Jianan-Li/Tiny-Tetris/Electrical Design/Tiny Tetris v1.3.brd

## EAGLE design Electrical Design/Tiny Tetris v1.3.brd (2014-08-16)

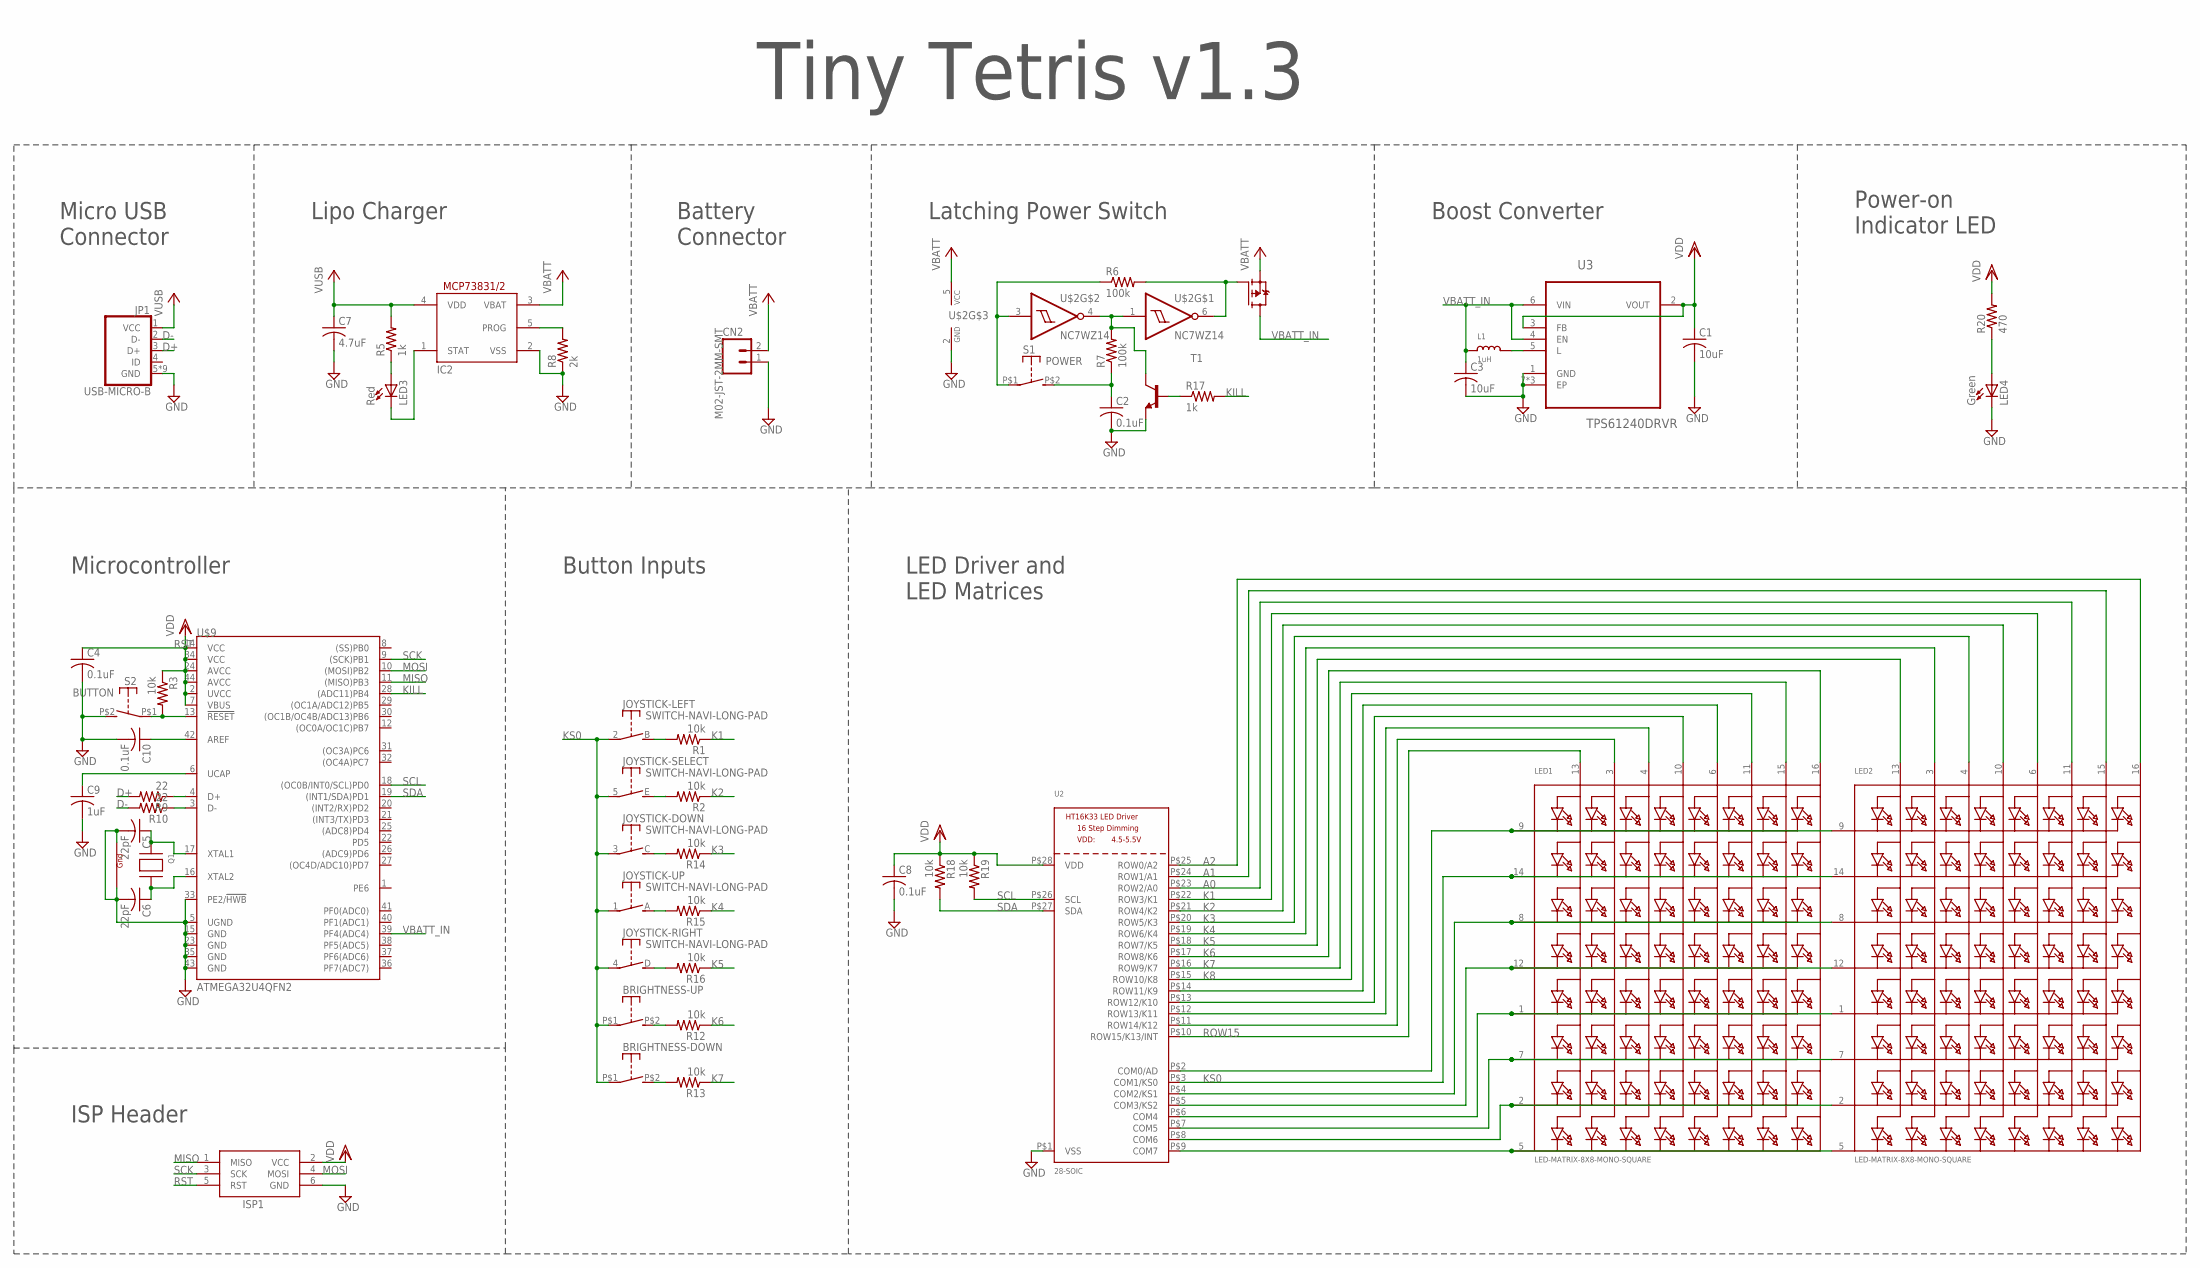
[picture p1: schematic Tiny Tetris v1.3.sch]

Parts:
BRIGHTNESS-DOWN: SWITCH-TACTSKRELGE010; TACT-ALPS-SKRELGE010
BRIGHTNESS-UP: SWITCH-TACTSKRELGE010; TACT-ALPS-SKRELGE010
C1, C3: 10uF; C0603K
C2, C4, C8, C10: 0.1uF; C0603K
C5, C6: 22pF; C0603K
C7: 4.7uF; C0603K
C9: 1uF; C0603K
CN2: M02-JST-2MM-SMT; 1X02_NO_SILK
IC2: MCP73831/OT; SOT23-5L
ISP1: AVRISP-6; AVRISP
JOYSTICK-: SWITCH-NAVI-LONG-PAD; JOYSTICK-NOKIA-3230-LONG-PAD
JP1: USB-MICRO-B; MICRO-USB-FCI-10103594
L1: 1uH; 0805
LED1, LED2: LED-MATRIX-8X8-MONO-SQUARE
LED3: Red; LED-0603-SIDEVIEW
LED4: Green; LED-0603-SIDEVIEW
Q1: XTAL-4-3225; NX3225
R1, R2, R3, R12, R13, R14, R15, R16, R18, R19: 10k; R0603
R5, R17: 1k; R0603
R6, R7: 100k; R0603
R8: 2k; R0603
R9, R10: 22; R0603
R20: 470; R0603
S1: POWER; TACT-ALPS-SKRELGE010
S2: BUTTON; TACT-ALPS-SKRELGE010
T1: MMBT2222ALT1-NPN-SOT23-BEC; SOT23-BEC
U2: 28-SOIC; SOP28_300MIL
U3: TPS61240DRVR; SON65P200X200X80-7N
U$1: IRLML6402; SOT23
U$2: NC7WZ14; SC-70-6
U$9: ATMEGA32U4QFN2; SPARKFUN-DIGITALIC_QFN-44-NOPAD

Connections:
A0: LED2.11 (A6), U2.P$23 (ROW2/A0)
A1: LED2.15 (A7), U2.P$24 (ROW1/A1)
A2: LED2.16 (A8), U2.P$25 (ROW0/A2)
D+: JP1.3 (D+), R9.2
D-: JP1.2 (D-), R10.2
GND: C1.2, C2.2, C3.2, C4.2, C5.2, C6.2, C7.2, C8.2, C9.2, C10.2, CN2.1, IC2.2 (VSS), ISP1.6 (GND), JP1.5 (GND), JP1.P$1 (GND), JP1.P$2 (GND), JP1.P$3 (GND), JP1.P$4 (GND), JP1.P$5 (GND), JP1.P$6 (GND), JP1.P$7 (GND), JP1.P$8 (GND), LED4.P$2 (C), Q1.2 (G2), Q1.4 (G1), R8.1, S2.P$2 (S), T1.E, U2.P$1 (VSS), U3.1 (GND), U3.7 (EP), U3.8 (EP), U3.9 (EP), U$2.2 (GND), U$9.5 (UGND), U$9.15 (GND), U$9.23 (GND), U$9.33 (PE2/!HWB), U$9.35 (GND), U$9.43 (GND)
K1: LED2.6 (A5), R1.1, U2.P$22 (ROW3/K1)
K2: LED2.10 (A4), R2.1, U2.P$21 (ROW4/K2)
K3: LED2.4 (A3), R14.1, U2.P$20 (ROW5/K3)
K4: LED2.3 (A2), R15.1, U2.P$19 (ROW6/K4)
K5: LED2.13 (A1), R16.1, U2.P$18 (ROW7/K5)
K6: LED1.16 (A8), R12.1, U2.P$17 (ROW8/K6)
K7: LED1.15 (A7), R13.1, U2.P$16 (ROW9/K7)
K8: LED1.11 (A6), U2.P$15 (ROW10/K8)
KILL: R17.2, U$9.28 ((ADC11)PB4)
KS0: BRIGHTNESS-DOWN.P$1, BRIGHTNESS-UP.P$1, JOYSTICK-.1, JOYSTICK-.2, JOYSTICK-.3, JOYSTICK-.4, JOYSTICK-.5, LED1.14 (K2), LED2.14 (K2), U2.P$3 (COM1/KS0)
MISO: ISP1.1 (MISO), U$9.11 ((MISO)PB3)
MOSI: ISP1.4 (MOSI), U$9.10 ((MOSI)PB2)
unnamed: LED1.5 (K8), LED2.5 (K8), U2.P$9 (COM7)
unnamed: LED3.P$1 (A), R5.1
unnamed: JOYSTICK-.C (S), R14.2
unnamed: R6.2, U$1.1 (G), U$2.6 (O)
unnamed: R17.1, T1.B
unnamed: R6.1, S1.P$1, U$2.3 (I)
unnamed: JOYSTICK-.E (S), R2.2
unnamed: LED1.9 (K1), LED2.9 (K1), U2.P$2 (COM0/AD)
unnamed: JOYSTICK-.D (S), R16.2
unnamed: C2.1, R7.1, S1.P$2 (S)
unnamed: JOYSTICK-.B (S), R1.2
unnamed: R7.2, T1.C, U$2.1 (I), U$2.4 (O)
unnamed: JOYSTICK-.A (S), R15.2
unnamed: C10.1, U$9.42 (AREF)
unnamed: R9.1, U$9.4 (D+)
unnamed: IC2.1 (STAT), LED3.P$2 (C)
unnamed: IC2.5 (PROG), R8.2
unnamed: R10.1, U$9.3 (D-)
unnamed: C9.1, U$9.6 (UCAP)
unnamed: BRIGHTNESS-UP.P$2 (S), R12.2
unnamed: LED1.3 (A2), U2.P$11 (ROW14/K12)
unnamed: LED1.4 (A3), U2.P$12 (ROW13/K11)
unnamed: LED1.10 (A4), U2.P$13 (ROW12/K10)
unnamed: LED1.6 (A5), U2.P$14 (ROW11/K9)
unnamed: BRIGHTNESS-DOWN.P$2 (S), R13.2
unnamed: LED4.P$1 (A), R20.1
unnamed: L1.2, U3.5 (L)
unnamed: LED1.8 (K3), LED2.8 (K3), U2.P$4 (COM2/KS1)
unnamed: C5.1, Q1.1 (X1), U$9.17 (XTAL1)
unnamed: LED1.12 (K4), LED2.12 (K4), U2.P$5 (COM3/KS2)
unnamed: LED1.1 (K5), LED2.1 (K5), U2.P$6 (COM4)
unnamed: LED1.7 (K6), LED2.7 (K6), U2.P$7 (COM5)
unnamed: LED1.2 (K7), LED2.2 (K7), U2.P$8 (COM6)
unnamed: C6.1, Q1.3 (X2), U$9.16 (XTAL2)
ROW15: LED1.13 (A1), U2.P$10 (ROW15/K13/INT)
RST: ISP1.5 (RST), R3.2, S2.P$1, U$9.13 (!RESET)
SCK: ISP1.3 (SCK), U$9.9 ((SCK)PB1)
SCL: R19.2, U2.P$26 (SCL), U$9.18 ((OC0B/INT0/SCL)PD0)
SDA: R18.2, U2.P$27 (SDA), U$9.19 ((INT1/SDA)PD1)
VBATT: CN2.2, IC2.3 (VBAT), U$1.2 (S), U$2.5 (VCC)
VBATT_IN: C3.1, L1.1, U3.4 (EN), U3.6 (VIN), U$1.3 (D), U$9.39 (PF4(ADC4))
VDD: C1.1, C4.1, C8.1, ISP1.2 (VCC), R3.1, R18.1, R19.1, R20.2, U2.P$28 (VDD), U3.2 (VOUT), U3.3 (FB), U$9.2 (UVCC), U$9.7 (VBUS), U$9.14 (VCC), U$9.24 (AVCC), U$9.34 (VCC), U$9.44 (AVCC)
VUSB: C7.1, IC2.4 (VDD), JP1.1 (VCC), R5.2

Notes on the sheet:
Tiny Tetris v1.3
Lipo Charger
LED Driver and LED Matrices
Microcontroller
Button Inputs
Boost Converter
Latching Power Switch
Micro USB Connector
Power-on Indicator LED
ISP Header
Battery Connector

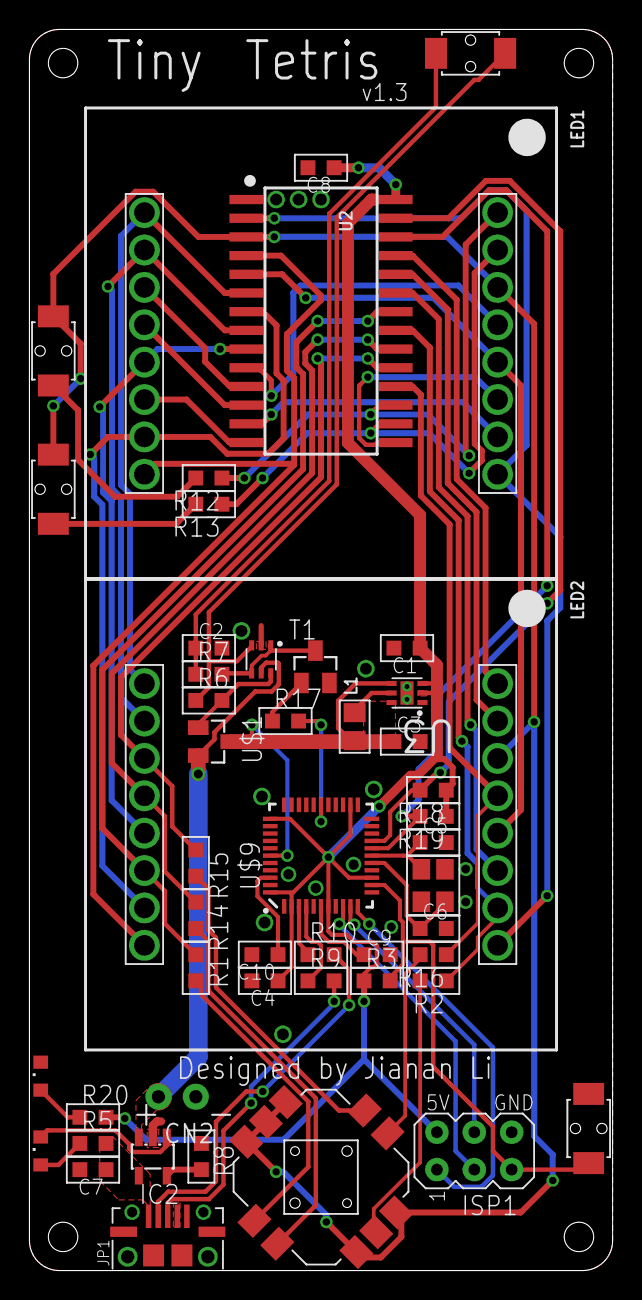
[picture p2: board Tiny Tetris v1.3.brd from above]

Board: 2 copper layers, 39.6 x 84.3 mm, 49 parts (0 on the bottom side), 61 nets.
