Jianan-Li/Tiny-Tetris/(commit log)

2014-08-16 add EAGLE source files
    [Tiny Tetris v1.0.brd, Tiny Tetris v1.0.sch, Tiny Tetris v1.1.brd, Tiny Tetris v1.1.sch, Tiny Tetris v1.2.brd, Tiny Tetris v1.2.sch, Tiny Tetris v1.3.brd, Tiny Tetris v1.3.sch]
2014-08-20 add Arduino files
2014-08-20 add enclosure design
2016-12-03 Fix bug in the HT16K33 driver.
2016-12-03 Clean up the latest schematic.
    [Tiny Tetris v1.3.sch]
2016-12-03 Change folder naming
    [Nav Switch v1.brd, Nav Switch v1.sch, Nav Switch v2.brd, Nav Switch v2.sch, Tiny Tetris v1.0.brd, Tiny Tetris v1.0.sch, Tiny Tetris v1.1.brd, Tiny Tetris v1.1.sch]
